jaafreitas/LousaMagica/(commit log)

2017-11-19 Versão inicial com WebService utilizando dados de apenas uma porta analógica.
2017-11-19 Utilizando o conversor analógico-digital ADS1115 para extender o número de portas analógicas disponíveis.
2017-11-19 Utilizando limites para a leitura dos valores do ADC.
2017-11-19 Implementação do tilt. Detalhamento de como as conexões são feitas.
2017-11-20 A utilização da macro constrain fez o número de amostrar por segundo despencar de 28 para 10.
2017-11-20 Otimizações e contornos para conseguirmos pelo menos 30 amostras de Xe Y por segundo. Medidas de amostragem estão disponíveis no terminal. Utilização de NETWORK_ESP8266_ASYNC na biblioteca WebSockets.
2017-11-27 Após a montagem física, trocamos alguns potenciômetros de lugar.
2017-11-27 Webserver utilizando sistema de arquivos locais.
2017-11-27 Desistindo de conectar no wifi quando não estiver disponível.
2017-11-28 Estamos também enviando a informação da matriz HSB para que todos os clientes conectados possam reproduzir a mesma cor.
2017-11-28 Imagens para documentação.
2017-11-28 Exemplso de criação
2017-12-03 Implementação de fila FIFO para garantir que todos os pontos são desenhados.
2017-12-03 O modo Wifi é setado conforme a disponibilidade de rede.
2017-12-04 Devido a algumas plataformas não terem suporte ao mDNS, vamos utilizar location.hostname onde for possível. Mais informações para auxiliar na depuração.
